GonReina/BudgetODMR/theory/coils/out/coil_designs.txt

== zf_scan_Z: 6 mT at the centre ==
  bore r_in 30 mm (diameter 60 mm), outer r 39.9 mm, winding 9.9 x 9.9 mm
  wire 1.0 mm Cu (1.10 mm enamelled), 9 layers x 9 turns = 81 turns per coil
  spacing 35.1 mm centre-centre (d2B/dz2 = 0);  2.076 mT/A
  current 2.89 A (3.7 A/mm2), 2.6 V, 7.5 W for the pair, R 0.78 ohm cold / 0.89 hot
  wire 36 m for the pair (250 g Cu)
  winding temperature (still air, h=12): 58 C
  inductance 1.47 mH, L/R 1.65 ms, f_3dB 96.6 Hz
  modulation at 1000 Hz: 4.5 V per mT amplitude; 12 V drive -> 2.678 mT
  homogeneity: 1.3e-06 (0.01 uT) over a 2.0 mm cube; 1e-3 region 12.2 mm (axis) x 15.3 mm (dia); 1e-2 region 22.1 x 26.5 mm

== zf_transverse_X: 2 mT at the centre ==
  bore r_in 50 mm (diameter 100 mm), outer r 57.1 mm, winding 7.1 x 7.1 mm
  wire 0.8 mm Cu (0.88 mm enamelled), 8 layers x 8 turns = 64 turns per coil
  spacing 53.6 mm centre-centre (d2B/dz2 = 0);  1.074 mT/A
  current 1.86 A (3.7 A/mm2), 3.0 V, 5.6 W for the pair, R 1.47 ohm cold / 1.63 hot
  wire 43 m for the pair (194 g Cu)
  winding temperature (still air, h=12): 47 C
  inductance 1.82 mH, L/R 1.12 ms, f_3dB 142.0 Hz
  homogeneity: 2.4e-07 (0.00 uT) over a 2.0 mm cube; 1e-3 region 18.6 mm (axis) x 23.5 mm (dia); 1e-2 region 33.7 x 40.6 mm

== zf_transverse_Y: 2 mT at the centre ==
  bore r_in 70 mm (diameter 140 mm), outer r 78.8 mm, winding 8.8 x 8.8 mm
  wire 0.8 mm Cu (0.88 mm enamelled), 10 layers x 10 turns = 100 turns per coil
  spacing 74.5 mm centre-centre (d2B/dz2 = 0);  1.208 mT/A
  current 1.66 A (3.3 A/mm2), 5.9 V, 9.7 W for the pair, R 3.20 ohm cold / 3.53 hot
  wire 94 m for the pair (421 g Cu)
  winding temperature (still air, h=12): 46 C
  inductance 6.39 mH, L/R 1.81 ms, f_3dB 88.0 Hz
  homogeneity: 6.4e-08 (0.00 uT) over a 2.0 mm cube; 1e-3 region 25.9 mm (axis) x 32.5 mm (dia); 1e-2 region 46.8 x 56.5 mm

== zf_modulation: 0.5 mT at the centre ==
  bore r_in 20 mm (diameter 40 mm), outer r 22.2 mm, winding 2.2 x 2.2 mm
  wire 0.5 mm Cu (0.56 mm enamelled), 4 layers x 4 turns = 16 turns per coil
  spacing 21.1 mm centre-centre (d2B/dz2 = 0);  0.681 mT/A
  current 0.73 A (3.7 A/mm2), 0.3 V, 0.2 W for the pair, R 0.37 ohm cold / 0.39 hot
  wire 4 m for the pair (7 g Cu)
  winding temperature (still air, h=12): 29 C
  inductance 0.05 mH, L/R 0.12 ms, f_3dB 1275.4 Hz
  modulation at 1000 Hz: 0.7 V per mT amplitude; 12 V drive -> 16.677 mT
  homogeneity: 9.8e-06 (0.00 uT) over a 2.0 mm cube; 1e-3 region 7.3 mm (axis) x 9.2 mm (dia); 1e-2 region 13.3 x 16.1 mm

== bias_200mT: 200 mT at the centre ==
  bore r_in 15 mm (diameter 30 mm), outer r 115.0 mm, winding 100.0 x 100.0 mm
  wire 1.5 mm Cu (1.64 mm enamelled), 61 layers x 61 turns = 3721 turns per coil
  spacing 102.0 mm centre-centre (windings touching: thicker than Helmholtz allows);  38.143 mT/A
  current 5.24 A (3.0 A/mm2), 155.2 V, 813.6 W for the pair, R 29.59 ohm cold / 29.59 hot  (cold: kept at 20 C)
  wire 3040 m for the pair (48139 g Cu)
  winding temperature (still air, h=12): RUNAWAY: needs forced/water cooling
  inductance 2127.82 mH, L/R 71.91 ms, f_3dB 2.2 Hz
  homogeneity: 1.6e-05 (3.22 uT) over a 2.0 mm cube; 1e-3 region 1.8 mm (axis) x 18.1 mm (dia); 1e-2 region 1.8 x 27.0 mm
