GonReina/BudgetODMR/theory/proposal/selfosc_data/selfosc_fm_gainscan.csv

# self-oscillation gain scan | 2026-07-10T14:34:53 | f_star_MHz=2867.90000 | R0_V=1.01510696e-04 | D_V_per_MHz=1.03149662e-04 | gamma_MHz_per_mT=28.024
gain | cycle | t_s | f_MHz | R_V
0.6 | 0 | 0.4063 | 2867.691707 | 1.37319601e-04
0.6 | 1 | 0.8446 | 2868.028861 | 4.35484304e-05
0.6 | 2 | 1.2444 | 2867.695050 | 1.58898332e-04
0.6 | 3 | 1.6530 | 2867.846327 | 7.55037097e-05
0.6 | 4 | 2.0766 | 2868.037622 | 6.86239940e-05
0.6 | 5 | 2.4769 | 2867.685594 | 1.62029969e-04
0.6 | 6 | 2.8607 | 2868.044443 | 3.98187181e-05
0.6 | 7 | 3.2556 | 2867.718521 | 1.57542056e-04
0.6 | 8 | 3.6530 | 2867.807668 | 8.61848592e-05
0.6 | 9 | 4.1078 | 2867.882835 | 8.85883140e-05
0.6 | 10 | 4.5073 | 2867.768125 | 1.21231045e-04
0.6 | 11 | 4.9361 | 2867.765034 | 1.02042143e-04
0.6 | 12 | 5.3254 | 2867.793601 | 9.65995903e-05
0.6 | 13 | 5.7692 | 2867.848765 | 9.20271381e-05
0.6 | 14 | 6.1691 | 2867.769192 | 1.15190554e-04
0.6 | 15 | 6.5727 | 2867.785905 | 9.86375263e-05
0.6 | 16 | 7.0047 | 2867.816051 | 9.63279689e-05
0.6 | 17 | 7.3932 | 2867.758578 | 1.11391378e-04
0.6 | 18 | 7.7631 | 2867.789473 | 9.61992811e-05
0.6 | 19 | 8.1439 | 2867.814168 | 9.72651455e-05
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
