GonReina/BudgetODMR/theory/proposal/selfosc_data/selfosc_fm_spectrum.csv

# FM spectrum for self-oscillation run | 2026-07-10T14:34:53
freq_MHz | lockin_R
2850.00000 | 0.00000346
2850.10000 | 0.00000360
2850.20000 | 0.00000509
2850.30000 | 0.00000436
2850.40000 | 0.00000346
2850.50000 | 0.00001463
2850.60000 | 0.00000360
2850.70000 | 0.00000555
2850.80000 | 0.00000328
2850.90000 | 0.00000278
2851.00000 | 0.00000280
2851.10000 | 0.00000508
2851.20000 | 0.00000144
2851.30000 | 0.00000439
2851.40000 | 0.00000431
2851.50000 | 0.00000541
2851.60000 | 0.00000392
2851.70000 | 0.00000346
2851.80000 | 0.00000283
2851.90000 | 0.00000436
2852.00000 | 0.00000338
2852.10000 | 0.00000444
2852.20000 | 0.00000592
2852.30000 | 0.00000591
2852.40000 | 0.00000561
2852.50000 | 0.00000537
2852.60000 | 0.00000398
2852.70000 | 0.00000414
2852.80000 | 0.00000983
2852.90000 | 0.00000509
2853.00000 | 0.00000732
2853.10000 | 0.00000578
2853.20000 | 0.00000780
2853.30000 | 0.00000422
2853.40000 | 0.00000846
2853.50000 | 0.00000927
2853.60000 | 0.00000933
2853.70000 | 0.00000434
2853.80000 | 0.00000903
2853.90000 | 0.00000498
2854.00000 | 0.00000537
2854.10000 | 0.00000471
2854.20000 | 0.00000595
2854.30000 | 0.00000628
2854.40000 | 0.00000689
2854.50000 | 0.00000627
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
