GonReina/BudgetODMR/theory/proposal/selfosc_data/selfosc_fm_stats.csv

# self-oscillation statistics | 2026-07-10T14:34:53 | gain=2.3 | f_star_MHz=2867.90000 | R0_V=1.01510696e-04 | D_V_per_MHz=1.03149662e-04
cycle | t_s | f_MHz | R_V
0 | 0.4305 | 2868.433662 | 7.75771821e-05
1 | 0.7725 | 2865.228724 | 2.45244733e-04
2 | 1.1687 | 2861.542838 | 2.66814139e-04
3 | 1.6156 | 2860.656032 | 1.41281872e-04
4 | 2.0041 | 2861.942542 | 4.38136999e-05
5 | 2.3978 | 2862.690450 | 6.79687813e-05
6 | 2.8294 | 2863.563481 | 6.23572760e-05
7 | 3.2189 | 2861.874308 | 1.77266204e-04
8 | 3.6149 | 2862.525684 | 7.22979713e-05
9 | 4.0369 | 2862.985278 | 8.08989680e-05
10 | 4.4504 | 2862.340044 | 1.30447947e-04
11 | 4.8347 | 2862.706690 | 8.50674689e-05
12 | 5.2635 | 2863.803029 | 5.23424467e-05
13 | 5.6672 | 2861.776788 | 1.92382904e-04
14 | 6.0629 | 2862.575888 | 6.56729076e-05
15 | 6.4957 | 2863.454125 | 6.21237973e-05
16 | 6.8851 | 2861.869283 | 1.72587207e-04
17 | 7.2818 | 2862.632355 | 6.72886925e-05
18 | 7.7025 | 2863.878647 | 4.56173721e-05
19 | 8.1175 | 2861.684772 | 1.99900884e-04
20 | 8.5503 | 2861.892376 | 9.22001641e-05
21 | 8.9338 | 2862.631852 | 6.83469000e-05
22 | 9.3281 | 2862.608349 | 1.02564735e-04
23 | 9.7619 | 2862.621431 | 1.00924012e-04
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
