GonReina/BudgetODMR/analysis/vsystem_sim_out/fig1_spectra.png

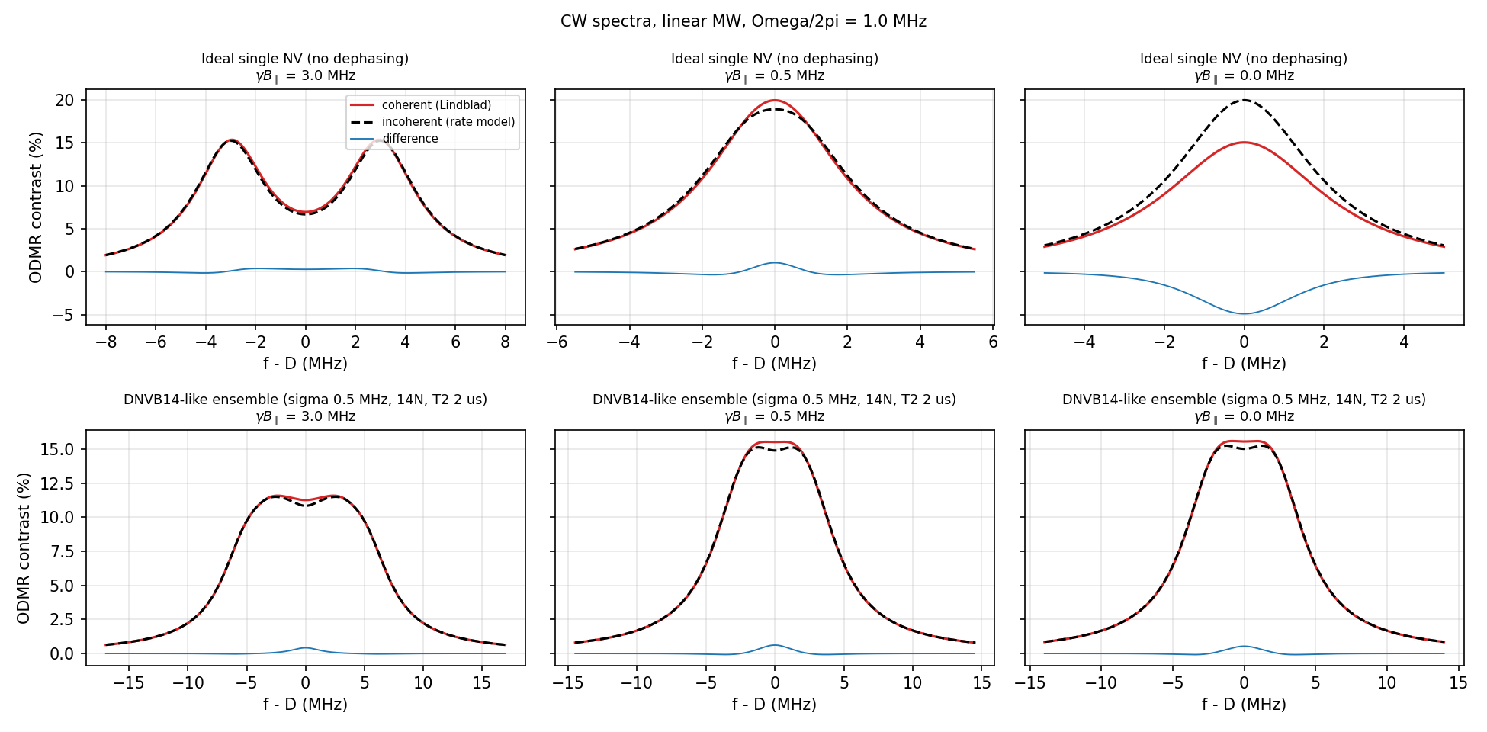
analysis/vsystem_sim_out/fig1_spectra.png
