GonReina/BudgetODMR/analysis/vsystem_sim_out/fig3_washout.png

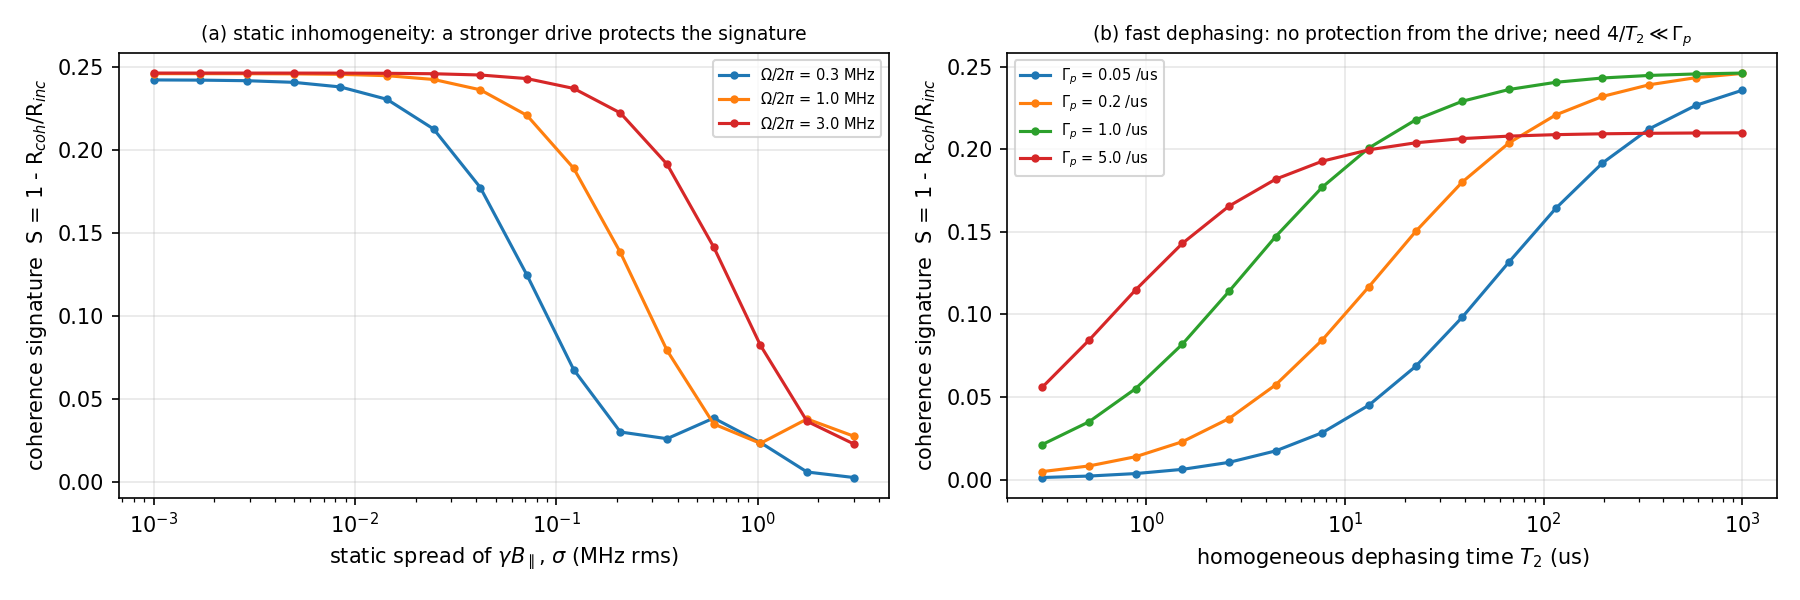
analysis/vsystem_sim_out/fig3_washout.png
