GonReina/BudgetODMR/analysis/vsystem_sim_out/fig4_lineshape_ambiguity.png

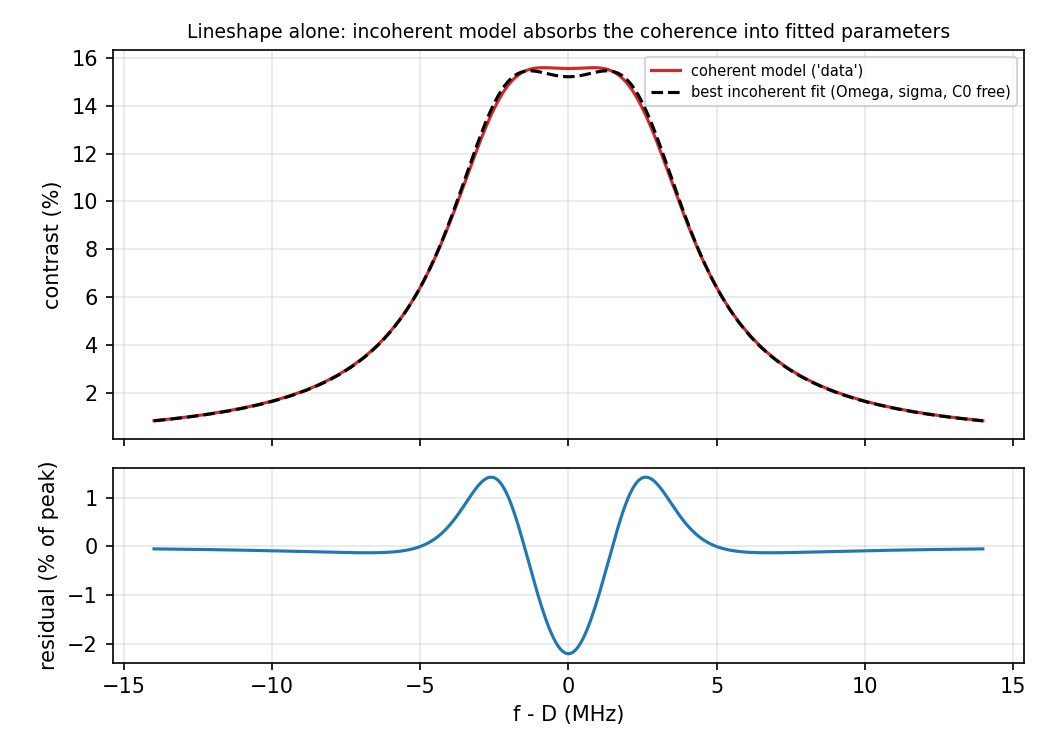
analysis/vsystem_sim_out/fig4_lineshape_ambiguity.png
