GonReina/BudgetODMR/analysis/vsystem_sim_out/fig5_time_domain.png

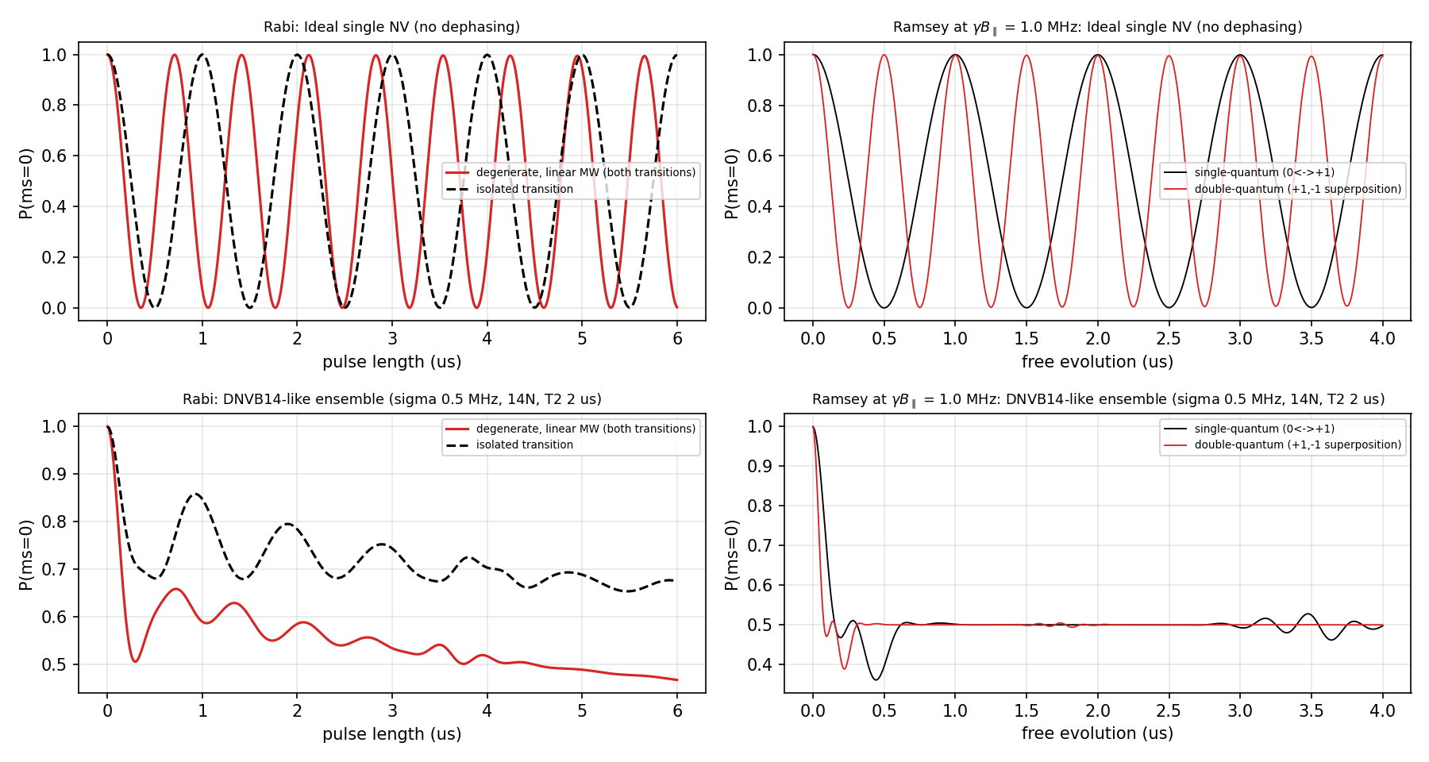
analysis/vsystem_sim_out/fig5_time_domain.png
