GonReina/BudgetODMR/analysis/vsystem_sim_out/fig6_pl_vs_rabi.png

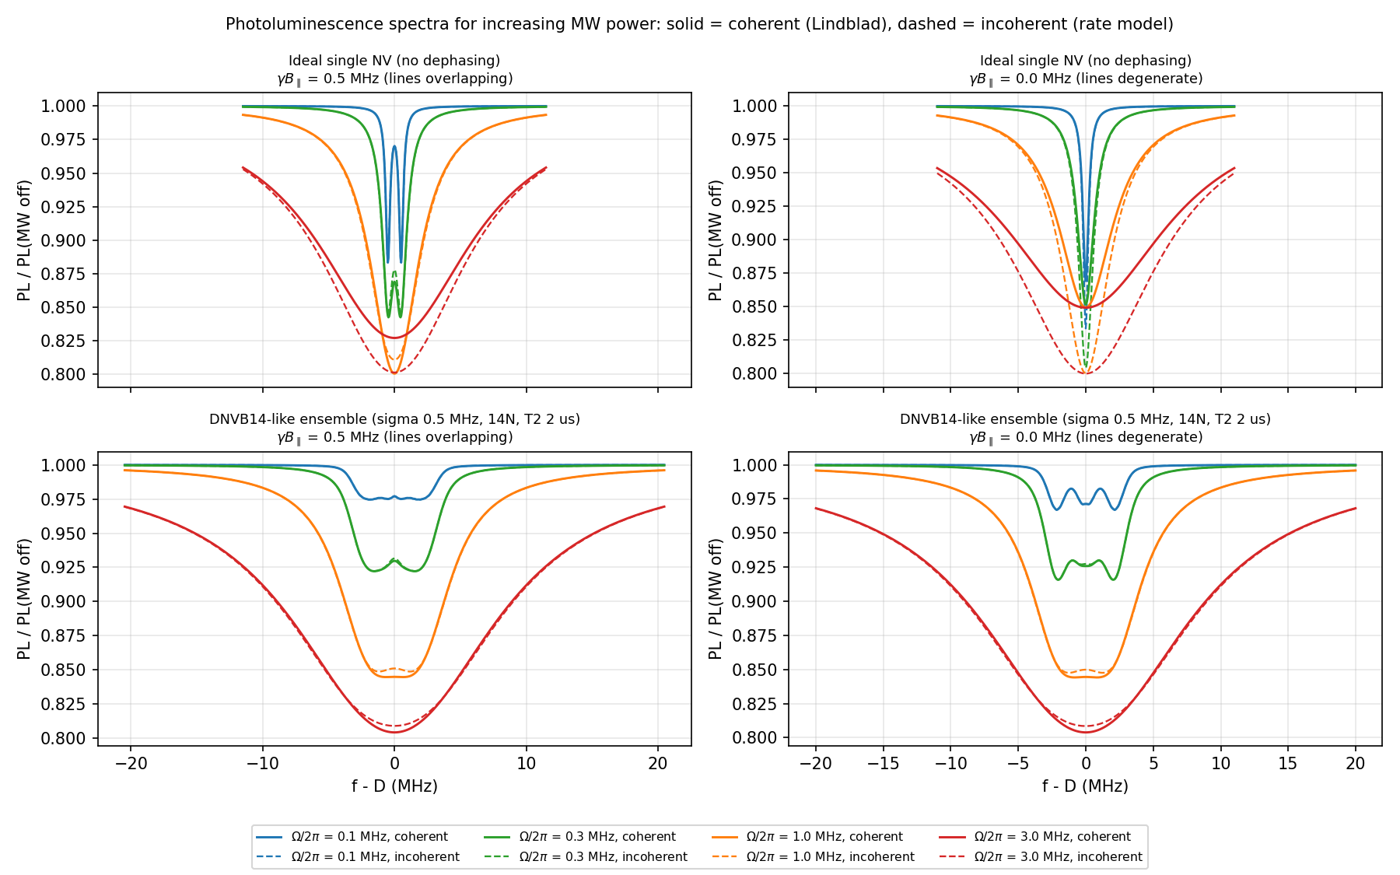
analysis/vsystem_sim_out/fig6_pl_vs_rabi.png
