GonReina/BudgetODMR/analysis/vsystem_sim_out/fig7_strain.png

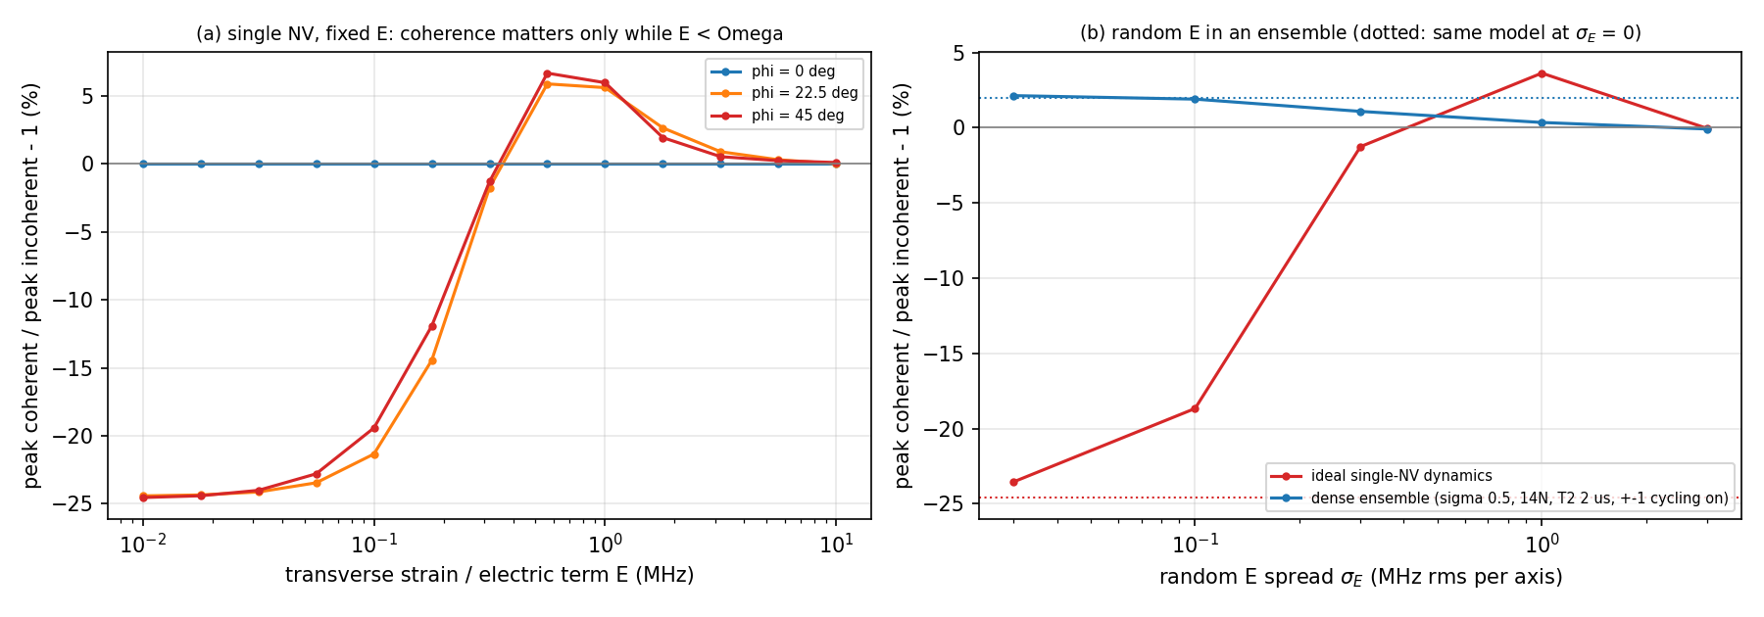
analysis/vsystem_sim_out/fig7_strain.png
