GonReina/BudgetODMR/proposal/fig4_threshold_detection.png

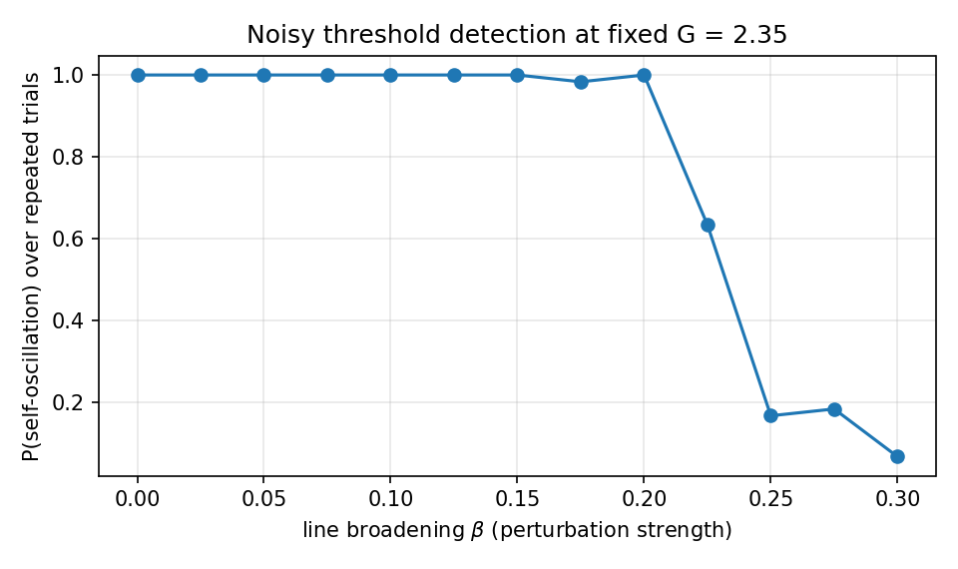
proposal/fig4_threshold_detection.png
