GonReina/BudgetODMR/proposal/figures/fig3_onset_sensor.png

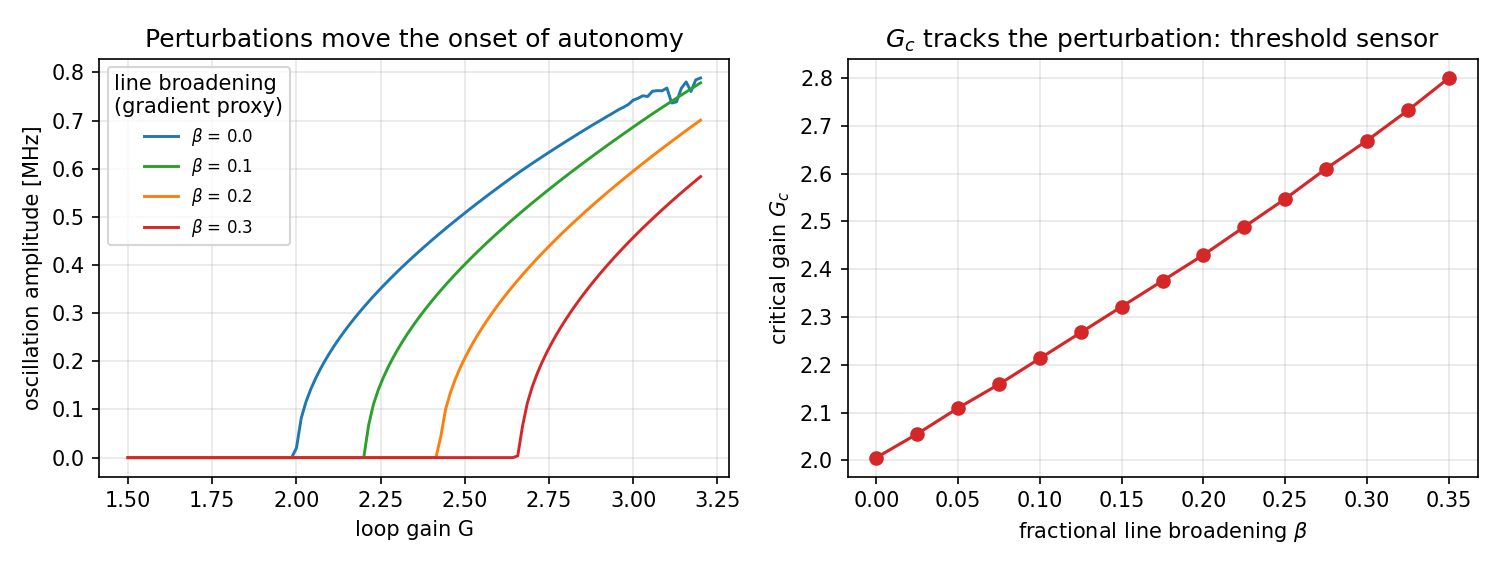
proposal/figures/fig3_onset_sensor.png
