GonReina/BudgetODMR/theory/coils/cad/preview/v1_single_axis.png

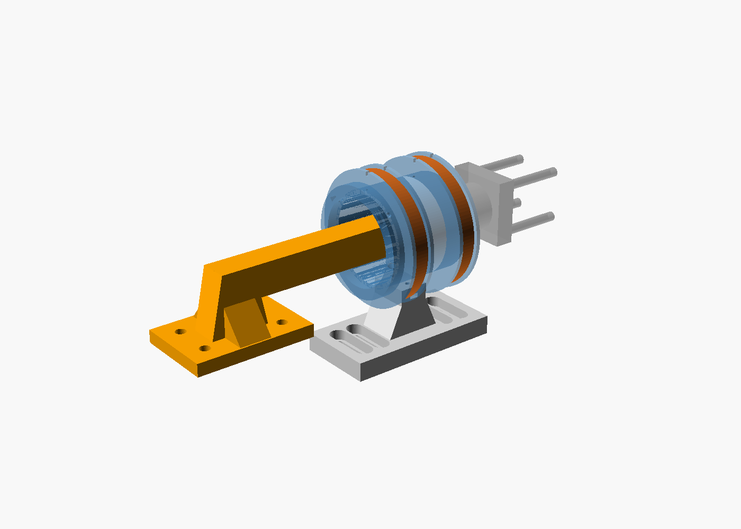
theory/coils/cad/preview/v1_single_axis.png
