GonReina/BudgetODMR/theory/coils/cad/preview/v3_three_axis.png

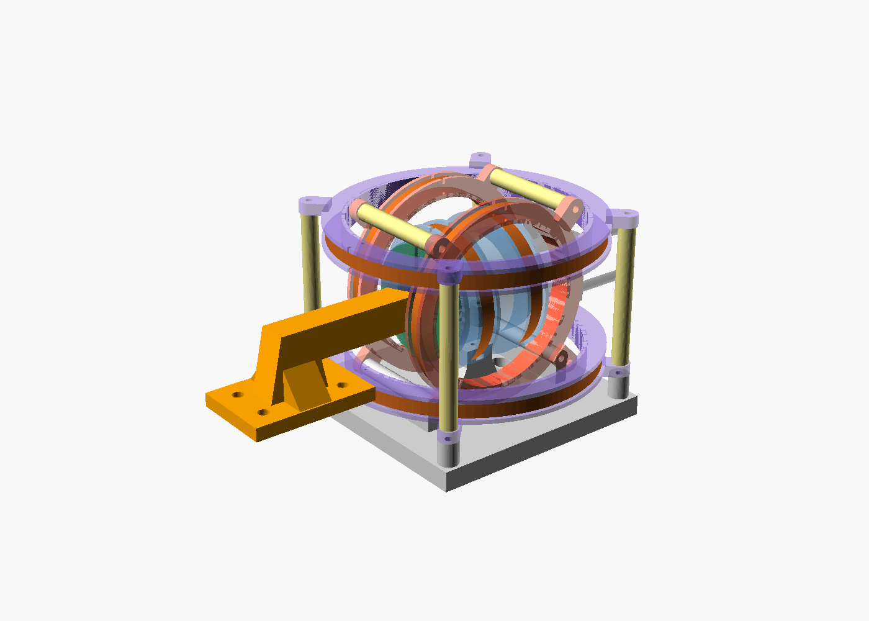
theory/coils/cad/preview/v3_three_axis.png
