GonReina/BudgetODMR/theory/coils/out/coil_bias_200mT.png

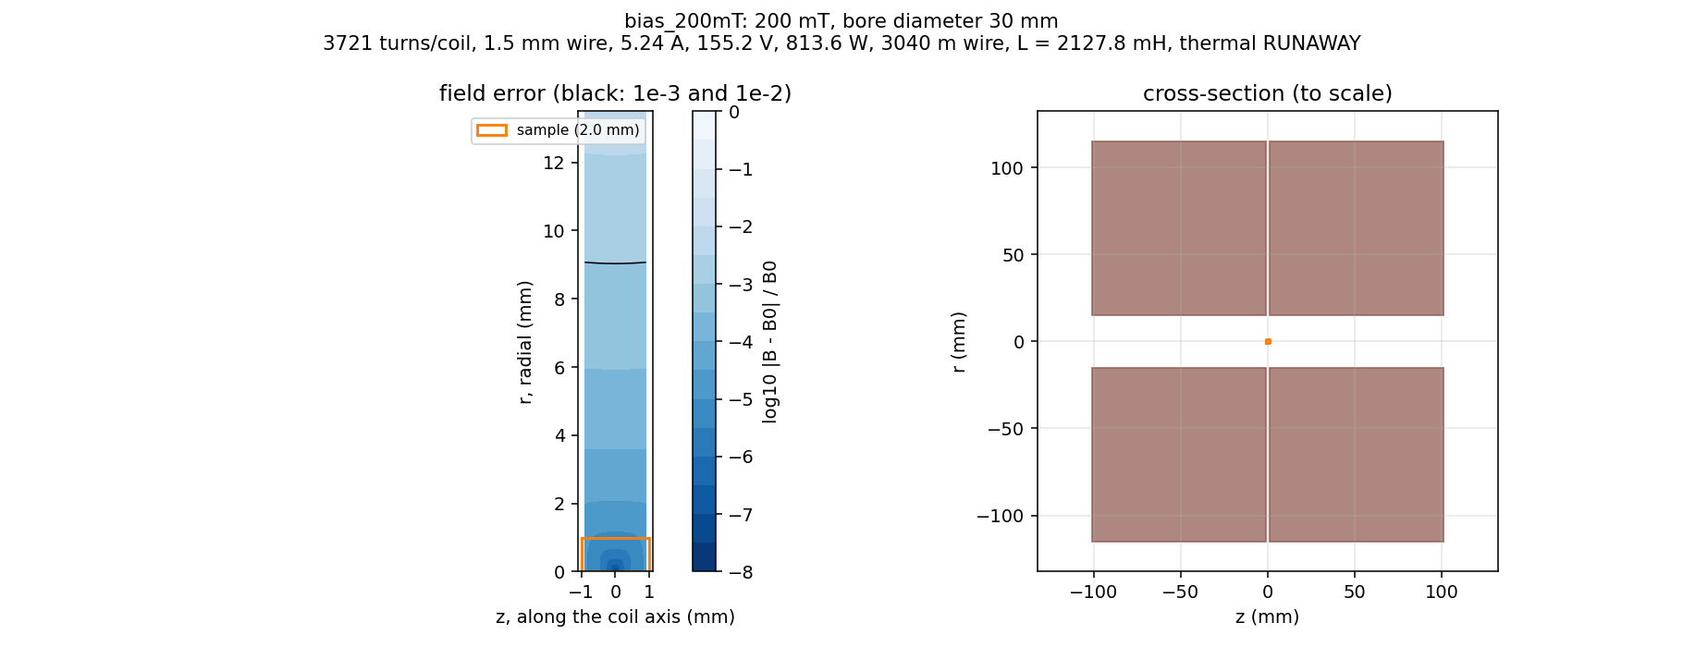
theory/coils/out/coil_bias_200mT.png
