GonReina/BudgetODMR/theory/coils/out/coil_sweep.png

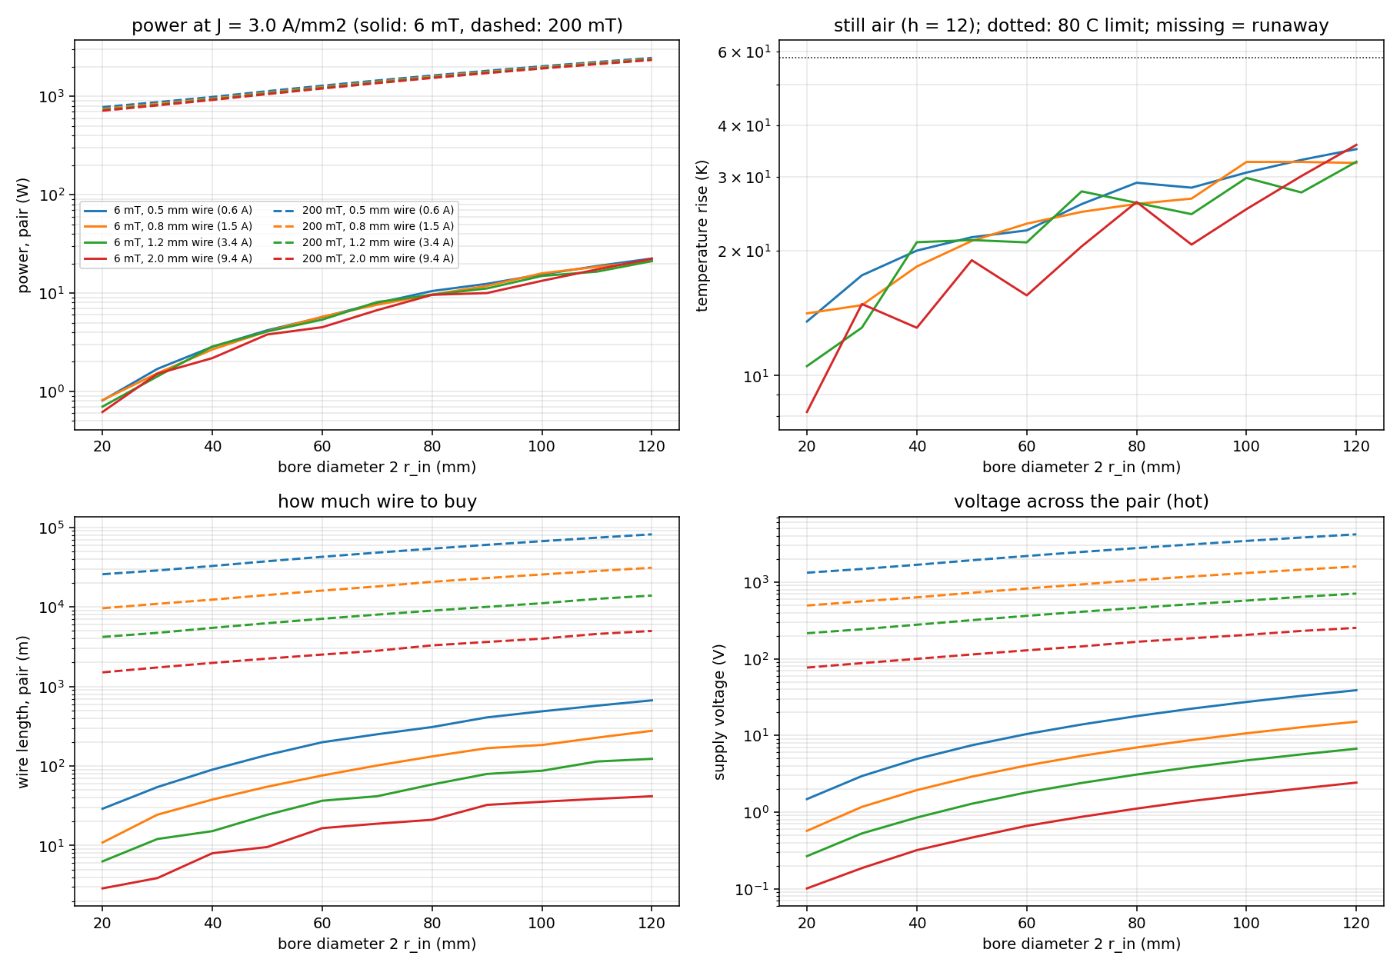
theory/coils/out/coil_sweep.png
