GonReina/BudgetODMR/theory/coils/out/coil_zf_modulation.png

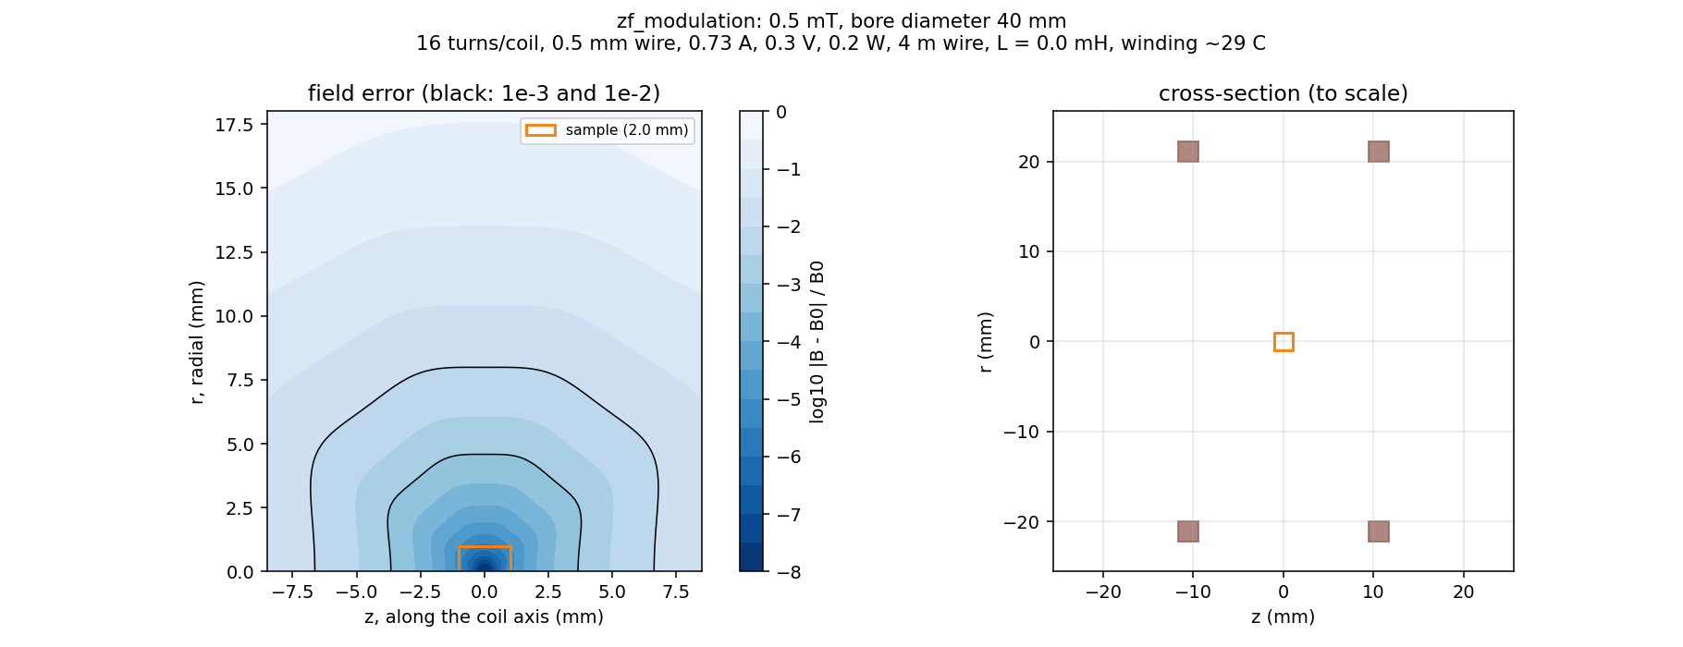
theory/coils/out/coil_zf_modulation.png
