GonReina/BudgetODMR/theory/coils/out/coil_zf_scan_Z.png

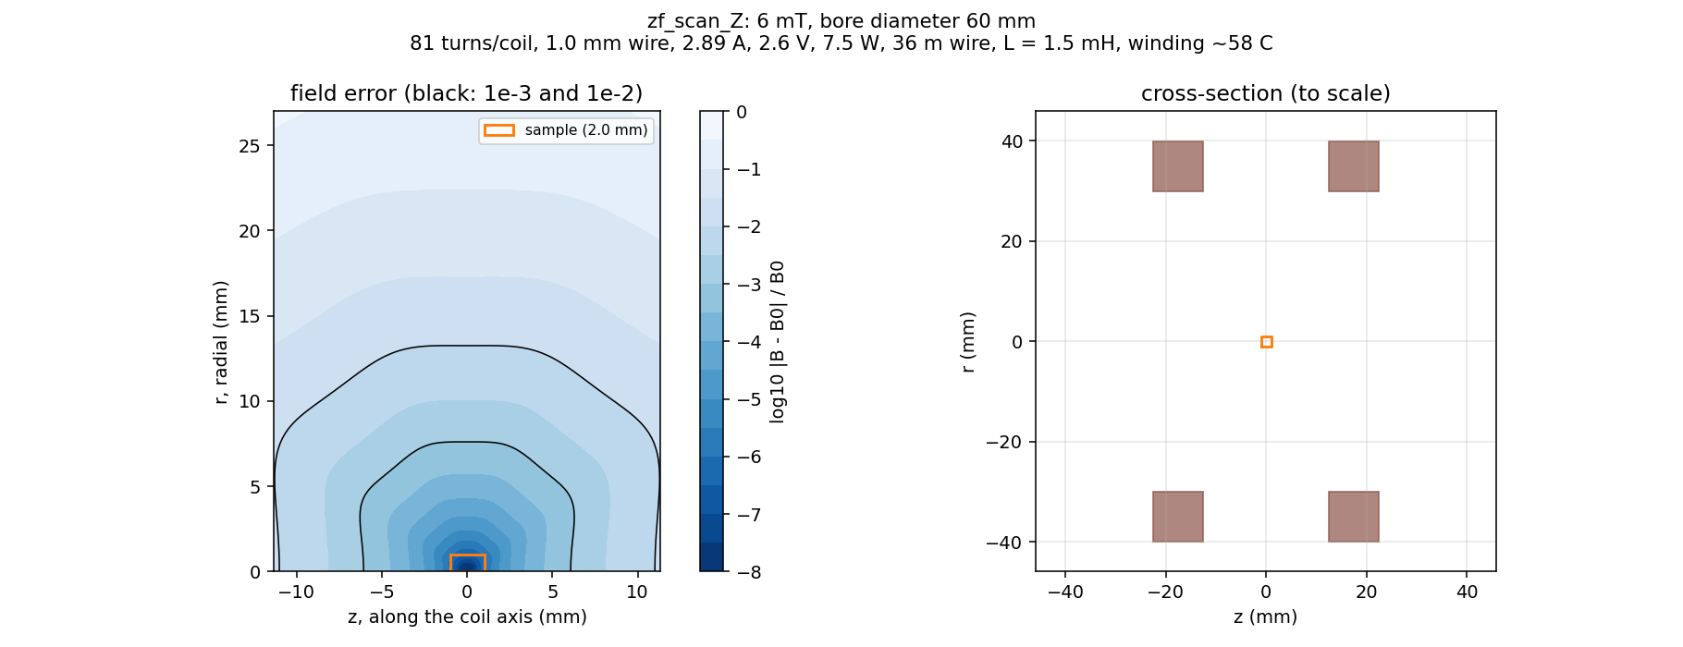
theory/coils/out/coil_zf_scan_Z.png
