GonReina/BudgetODMR/theory/coils/out/coil_zf_transverse_X.png

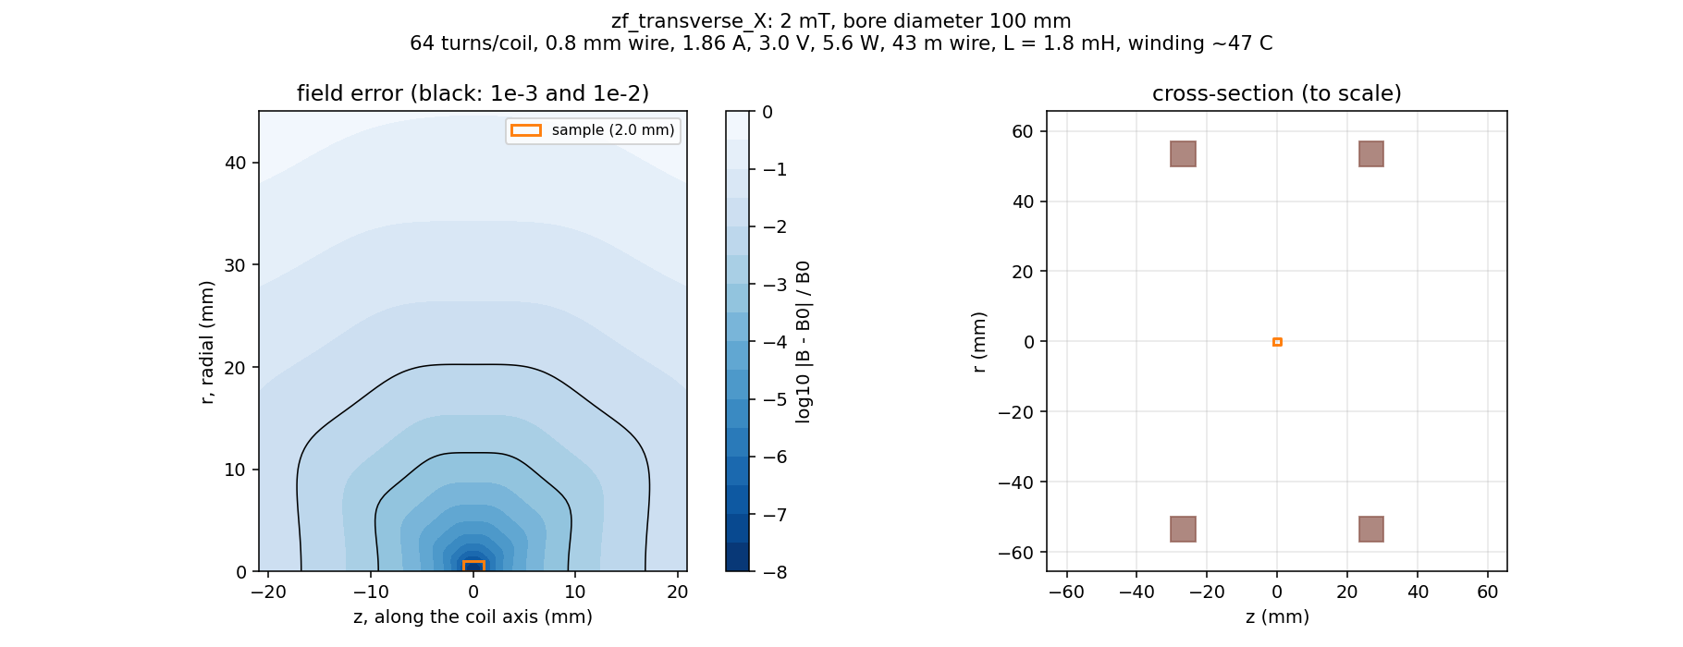
theory/coils/out/coil_zf_transverse_X.png
