GonReina/BudgetODMR/theory/proposal/figures/fig5_statistics_readout.png

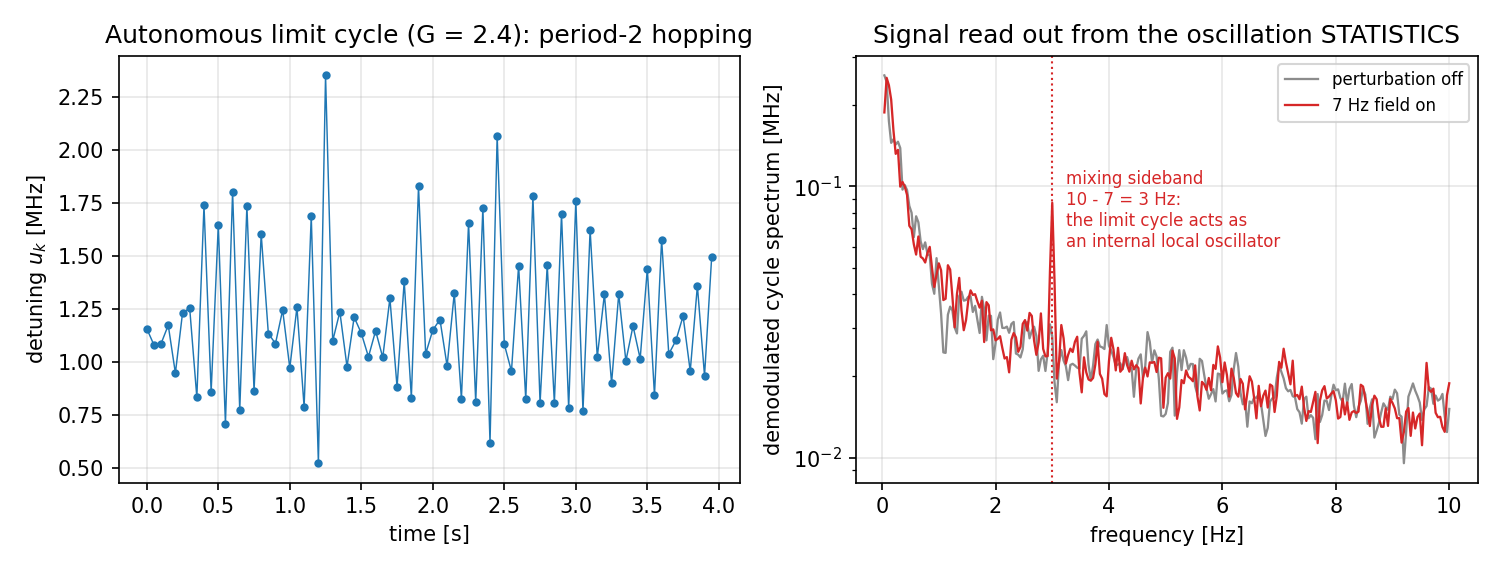
theory/proposal/figures/fig5_statistics_readout.png
