GonReina/BudgetODMR/procurement/NV_upgrade_shopping_list.xlsx

Sheet: Shopping list
BudgetODMR - NV magnetometer upgrade, procurement plan
All prices EUR, EXCLUDING VAT (21 % ES), as displayed by the vendor on 10 Sep 2026. Blue = price taken from our own earlier quote or an estimate; black = verified on the linked vendor page.
Tier | Group | Item | Part no. | Supplier | Qty | Unit price (EUR, ex-VAT) | Line total (EUR) | URL | Purpose / justification
1. Fluorescence collection & detection
A - core (3 k tranche) | 1. Fluorescence collection & detection | Si switchable-gain photodetector, 75.4 mm² active area | PDA100A2 | Thorlabs | 1 | 399.87 EUR | 399.87 EUR | https://www.thorlabs.com/thorproduct.cfm?partnumber=PDA100A2 | Dedicated high-collection ensemble channel: 94x larger area than the PDA10A2 and 8 selectable gains, so bandwidth we do not need is traded for transimpedance we do. Directly attacks the 0.1 mV lock-in signal.
A - core (3 k tranche) | 1. Fluorescence collection & detection | Aspheric condenser, Ø25 mm, f = 16 mm, NA = 0.79, AR 650-1050 nm | ACL25416U-B | Thorlabs | 2 | 31.21 EUR | 62.42 EUR | https://www.thorlabs.com/thorproduct.cfm?partnumber=ACL25416U-B | High-NA collection of NV emission close to the diamond, feeding the large-area detector. Far more efficient than re-using the 40x objective for ensemble work.
A - core (3 k tranche) | 1. Fluorescence collection & detection | SM1 lens tube, 1 in | SM1L10 | Thorlabs | 2 | 14.99 EUR | 29.98 EUR | https://www.thorlabs.com/thorproduct.cfm?partnumber=SM1L10 | Builds the condenser + filter + detector head as one light-tight tube.
A - core (3 k tranche) | 1. Fluorescence collection & detection | Lens mount for Ø1 in optics, M4 tap | LMR1/M | Thorlabs | 2 | 16.02 EUR | 32.04 EUR | https://www.thorlabs.com/thorproduct.cfm?partnumber=LMR1/M | Mounting for the condenser lenses.
A - core (3 k tranche) | 1. Fluorescence collection & detection | Ø25 mm longpass filter, 650 nm cut-on | FELH0650 | Thorlabs | 1 | 153.86 EUR | 153.86 EUR | https://www.thorlabs.com/thorproduct.cfm?partnumber=FELH0650 | Rejects residual 532 nm and most room light while passing the NV phonon sideband (650-800 nm). Raises contrast by cutting background, not signal.
2. Stray-light control
A - core (3 k tranche) | 2. Stray-light control | Black hardboard, 610 x 610 mm, 3 sheets per pack | TB4 | Thorlabs | 2 | 73.95 EUR | 147.90 EUR | https://www.thorlabs.com/thorproduct.cfm?partnumber=TB4 | Rigid light-tight enclosure around the confocal head - the blocker for any low-light / single-NV work.
A - core (3 k tranche) | 2. Stray-light control | Blackout fabric, 1.5 m x 2.7 m | BK5 | Thorlabs | 1 | 61.64 EUR | 61.64 EUR | https://www.thorlabs.com/thorproduct.cfm?partnumber=BK5 | Drapes the enclosure and the table edges.
A - core (3 k tranche) | 2. Stray-light control | Matte black aluminium foil, 305 mm x 15.2 m | BKF12 | Thorlabs | 2 | 35.37 EUR | 70.74 EUR | https://www.thorlabs.com/thorproduct.cfm?partnumber=BKF12 | Mouldable foil to seal exactly the failure mode we have: cable holes and small apertures.
A - core (3 k tranche) | 2. Stray-light control | Beam trap, 400 nm - 2.5 µm, 30 W | BT610/M | Thorlabs | 1 | 342.00 EUR | 342.00 EUR | https://www.thorlabs.com/thorproduct.cfm?partnumber=BT610/M | Terminates the transmitted/reflected green safely instead of scattering it around the enclosure. Laser-safety item as well.
3. Fibre coupling
A - core (3 k tranche) | 3. Fibre coupling | Achromatic FiberPort, FC/PC & FC/APC, f = 7.5 mm, 400-700 nm | PAF2-A7A | Thorlabs | 1 | 681.22 EUR | 681.22 EUR | https://www.thorlabs.com/thorproduct.cfm?partnumber=PAF2-A7A | Integrated 5-axis fibre launch (x, y, focus + 2 tilts). Our current kinematic-mount approach cannot translate the fibre tip, which is why coupling has never succeeded. NOTE: check the collimated beam diameter first and pick the matching focal length (A4A 0.65 mm / A7A 1.23 mm / A10A / A15A) - all cost the same.
4. Microwave power characterisation
A - core (3 k tranche) | 4. Microwave power characterisation | Fixed attenuator 30 dB, 20 W, DC-18 GHz, SMA | BW-S30W20+ | DigiKey ES | 1 | 203.85 EUR | 203.85 EUR | https://www.digikey.es/es/products/detail/mini-circuits/BW-S30W20/16682977 | Lets the 16 W amplifier output be measured safely. Needed to find where the ZHL-16W-43-S+ compresses: with +16 dBm drive it is almost certainly saturated, so 'MW power' set on the SMCV may not be the power at the antenna.
A - core (3 k tranche) | 4. Microwave power characterisation | RF power detector, 10 MHz - 8 GHz, DC log output | ZX47-40-S+ | DigiKey ES | 1 | 149.31 EUR | 149.31 EUR | https://www.digikey.es/es/products/detail/mini-circuits/ZX47-40-S/21727781 | Calibrated MW power axis for the linewidth-vs-power (Rabi) experiment; DC output readable by the multimeter or the Red Pitaya.
A - core (3 k tranche) | 4. Microwave power characterisation | Absorptive SPDT RF switch, DC-5 GHz, TTL control | ZASWA-2-50DRA+ | DigiKey ES | 1 | 189.93 EUR | 189.93 EUR | https://www.digikey.es/es/products/result?keywords=ZASWA-2-50DRA%2B | TTL-gated MW from the Red Pitaya: deep 100% amplitude modulation for lock-in, MW on/off normalisation, and a first step towards pulsed sequences.
A - core (3 k tranche) | 4. Microwave power characterisation | Ultra-flexible SMA cable | (as quoted) | Mouser | 4 | 20.35 EUR | 81.40 EUR | https://www.mouser.es/c/?q=ultra%20flexible%20sma%20cable | Replaces stiff cables that torque the antenna and change coupling between runs. Price from our own earlier quote.
A - core (3 k tranche) | 4. Microwave power characterisation | SMA edge-launch connectors (antenna build) | (as quoted) | Mouser | 8 | 7.17 EUR | 57.36 EUR | https://www.mouser.es/c/connectors/rf-coaxial-connectors/ | For the resonant loop / Omega antenna PCB - stronger B1 is the cheapest route to better ODMR contrast. Price from our own earlier quote.
5. Temperature & drift
A - core (3 k tranche) | 5. Temperature & drift | USB temperature + humidity logger with external probe | TSP01 | Thorlabs | 1 | 158.29 EUR | 158.29 EUR | https://www.thorlabs.com/thorproduct.cfm?partnumber=TSP01 | Logs lab temperature alongside every ODMR run so drift in D (-74 kHz/K) can be separated from magnetic drift. Enables the thermometry experiment.
A - core (3 k tranche) | 5. Temperature & drift | Flexible polyimide heater with 10 kΩ thermistor | HT10K | Thorlabs | 2 | 59.79 EUR | 119.58 EUR | https://www.thorlabs.com/thorproduct.cfm?partnumber=HT10K | Deliberately warm the diamond mount to measure dD/dT and calibrate the setup as a thermometer; also quantifies laser-induced heating.
A - core (3 k tranche) | 5. Temperature & drift | 10 kΩ thermistor (spares / extra sensing points) | TH10K | Thorlabs | 4 | 4.84 EUR | 19.36 EUR | https://www.thorlabs.com/thorproduct.cfm?partnumber=TH10K | Additional temperature sensing points (antenna, amplifier, diamond mount).
6. Optics cleaning & consumables
A - core (3 k tranche) | 6. Optics cleaning & consumables | Lens tissues, 5 booklets | MC-5 | Thorlabs | 1 | 11.34 EUR | 11.34 EUR | https://www.thorlabs.com/thorproduct.cfm?partnumber=MC-5 | Standard drag-wipe cleaning of objective, filters and fibre ends.
A - core (3 k tranche) | 6. Optics cleaning & consumables | Optical-grade cotton-tipped applicators, 100 pack | CTA10 | Thorlabs | 1 | 4.97 EUR | 4.97 EUR | https://www.thorlabs.com/thorproduct.cfm?partnumber=CTA10 | Solvent cleaning of connector ferrules and small optics.
A - core (3 k tranche) | 6. Optics cleaning & consumables | Reagent-grade alcohol | (as quoted) | Amazon | 1 | 8.39 EUR | 8.39 EUR | https://www.amazon.es/s?k=isopropanol+99.9+reagent+grade | Cleaning solvent. Price from our own earlier quote.
A - core (3 k tranche) | 6. Optics cleaning & consumables | Deionised water | (as quoted) | Amazon | 1 | 10.30 EUR | 10.30 EUR | https://www.amazon.es/s?k=agua+desionizada | Cleaning solvent. Price from our own earlier quote.
 |  | TIER A SUBTOTAL - core upgrade (3,000 EUR tranche) |  |  |  |  | 2995.75 EUR
7. Balanced detection (laser-noise cancellation)
B - extension (2 k tranche) | 7. Balanced detection (laser-noise cancellation) | Si switchable-gain photodetector (reference channel) | PDA100A2 | Thorlabs | 1 | 399.87 EUR | 399.87 EUR | https://www.thorlabs.com/thorproduct.cfm?partnumber=PDA100A2 | Second identical detector on a pick-off of the excitation beam. Fed differentially into the MFLI it cancels common-mode laser intensity noise - the term the noise-budget script is most likely to find dominant.
B - extension (2 k tranche) | 7. Balanced detection (laser-noise cancellation) | Ø1 in UVFS wedged beam sampler, AR 350-700 nm | BSF10-A | Thorlabs | 1 | 72.51 EUR | 72.51 EUR | https://www.thorlabs.com/thorproduct.cfm?partnumber=BSF10-A | Picks off a few % of the green for the reference detector without disturbing the main beam.
8. Laser power control
B - extension (2 k tranche) | 8. Laser power control | Ø1 in linear polariser, 400-700 nm | LPVISE100-A | Thorlabs | 1 | 103.08 EUR | 103.08 EUR | https://www.thorlabs.com/thorproduct.cfm?partnumber=LPVISE100-A | With the rotation mount, gives continuous laser power control (Malus law) on the linearly polarised DPSS output - needed to take clean laser-power dependences without changing diode current (which changes noise and mode).
B - extension (2 k tranche) | 8. Laser power control | Rotation mount for Ø1 in optics, M4 tap | RSP1/M | Thorlabs | 1 | 95.73 EUR | 95.73 EUR | https://www.thorlabs.com/thorproduct.cfm?partnumber=RSP1/M | Rotates the polariser; also serves the half-wave plate later.
B - extension (2 k tranche) | 8. Laser power control | Absorptive ND filter OD 1.0, SM1-mounted | NE10A | Thorlabs | 1 | 58.34 EUR | 58.34 EUR | https://www.thorlabs.com/thorproduct.cfm?partnumber=NE10A | Coarse, repeatable power steps for power-dependence series.
B - extension (2 k tranche) | 8. Laser power control | Absorptive ND filter OD 2.0, SM1-mounted | NE20A | Thorlabs | 1 | 58.34 EUR | 58.34 EUR | https://www.thorlabs.com/thorproduct.cfm?partnumber=NE20A | As above, decade step.
9. Sample & fibre infrastructure
B - extension (2 k tranche) | 9. Sample & fibre infrastructure | PM patch cable, PANDA, 488 nm, FC/APC, 2 m | P3-488PM-FC-2 | Thorlabs | 1 | 282.24 EUR | 282.24 EUR | https://www.thorlabs.com/thorproduct.cfm?partnumber=P3-488PM-FC-2 | Spare/second fibre better matched to 532 nm than the 405 nm PM cable, and insurance against an end face damaged during coupling attempts. Keep connector types consistent (APC-APC) across the launch.
B - extension (2 k tranche) | 9. Sample & fibre infrastructure | 30 mm cage cube precision kinematic rotation platform | B4CRP/M | Thorlabs | 1 | 333.91 EUR | 333.91 EUR | https://www.thorlabs.com/thorproduct.cfm?partnumber=B4CRP/M | Rotates the diamond + antenna assembly reproducibly: NV-orientation studies, vector magnetometry, and repeatable magnet geometry. Already on our wish list.
B - extension (2 k tranche) | 9. Sample & fibre infrastructure | SM1 lens tube, 1 in (light shielding spares) | SM1L10 | Thorlabs | 2 | 14.99 EUR | 29.98 EUR | https://www.thorlabs.com/thorproduct.cfm?partnumber=SM1L10 | Extra shielding tubes for the detection path.
B - extension (2 k tranche) | 9. Sample & fibre infrastructure | Aspheric condenser (spare / second channel) | ACL25416U-B | Thorlabs | 1 | 31.21 EUR | 31.21 EUR | https://www.thorlabs.com/thorproduct.cfm?partnumber=ACL25416U-B | Spare for the balanced/second collection channel.
10. Field calibration
B - extension (2 k tranche) | 10. Field calibration | Calibration coil build: magnet wire, 3D-printed former, precision sense resistor | (build) | RS / Farnell / in-house | 1 | 80.00 EUR | 80.00 EUR | https://es.rs-online.com/web/c/cables-hilos/hilo-electrico/hilo-de-cobre-esmaltado/ | ESTIMATE. A coil of known geometry driven by the KA3010P or the Red Pitaya applies a computable field (N, r, I) so the nT/sqrt(Hz) sensitivity becomes traceable instead of relative, and gives a known AC signal for the WP3 statistics test.
11. Environment & contingency
B - extension (2 k tranche) | 11. Environment & contingency | Air purifier (optics dust control) | (as quoted) | Amazon | 1 | 199.00 EUR | 199.00 EUR | https://www.amazon.es/s?k=purificador+de+aire+HEPA | Reduces dust settling on the diamond, objective and open optics in a shared room. Price from our own earlier quote.
B - extension (2 k tranche) | 11. Environment & contingency | Cotton applicators + lens tissue (restock) | CTA10 / MC-5 | Thorlabs | 1 | 21.28 EUR | 21.28 EUR | https://www.thorlabs.com/thorproduct.cfm?partnumber=CTA10 | Consumable restock (2x CTA10 + 1x MC-5).
B - extension (2 k tranche) | 11. Environment & contingency | Contingency: shipping, M4/M6 adapters, low-profile screws, SMA savers | (various) | various | 1 | 234.00 EUR | 234.00 EUR | https://www.thorlabs.com/navigation.cfm?guide_id=51 | ESTIMATE. Small mechanical hardware identified during assembly plus carriage; keeps the tranche from stalling on 10 EUR parts.
 |  | TIER B SUBTOTAL - extension (2,000 EUR tranche) |  |  |  |  | 1999.49 EUR
 |  | GRAND TOTAL (ex-VAT) |  |  |  |  | 4995.24 EUR
 |  | Memo: same total including 21 % Spanish VAT |  |  |  |  | 6044.24 EUR | Check with the finance office which basis the 3 k + 2 k awards are quoted on.
Budget check
 |  | Tier A vs 3,000 EUR available |  |  |  |  | 4.25 EUR
 |  | Tier B vs 2,000 EUR available |  |  |  |  | 0.51 EUR
 |  | Total headroom vs 5,000 EUR |  |  |  |  | 4.76 EUR

Sheet: Considered - not bought
Items evaluated and deliberately excluded
Item | Indicative price (EUR) | Why it is not in this request
Single-photon counting module (e.g. Excelitas SPCM-AQRH) | ~6,000-8,000 | The only real route to single-NV work: the APD430A is an analogue detector and a single NV delivers femtoamps. Out of scope for this budget; propose as a separate capital request.
Zero-order half-wave plate WPH10M-532 (605.44) + mount | 605.44 | Would add NV-orientation-selective excitation on top of power control. Deferred - the polariser alone already gives continuous power control. First item to add if funds free up.
Thorlabs NEK01 ND filter kit (10 filters) | 617.07 | Two individual ND filters cover the needed range at 1/5 of the cost.
3B Scientific Helmholtz coil pair U8481500 | ~700 | Turnkey but 300 mm coils are oversized for the table and the field is easily computed from a wound coil at ~1/8 the price.
Second NV diamond with lower NV density | ~1,000-3,700 | Would give narrower lines and a resolvable 14N triplet for the Rabi work. Too expensive here; the existing ELSC20 should be tried first.
Zurich Instruments MFLI options (MF-MD multi-demodulator, MF-PID) | quote required | The only software licences worth considering: MF-MD would demodulate 1f and 2f simultaneously (derivative + absorption in one pass), MF-PID would move the WP3 feedback loop into hardware. Both need a quote from ZI - request before committing budget.
Analysis software licence (Origin, MATLAB, LabVIEW) | n/a | Not recommended: the acquisition and analysis stack is already Python/numpy/matplotlib and is written and tested.
