GonReina/BudgetODMR/theory/coils/cad/stl/v1_single_axis/base.stl

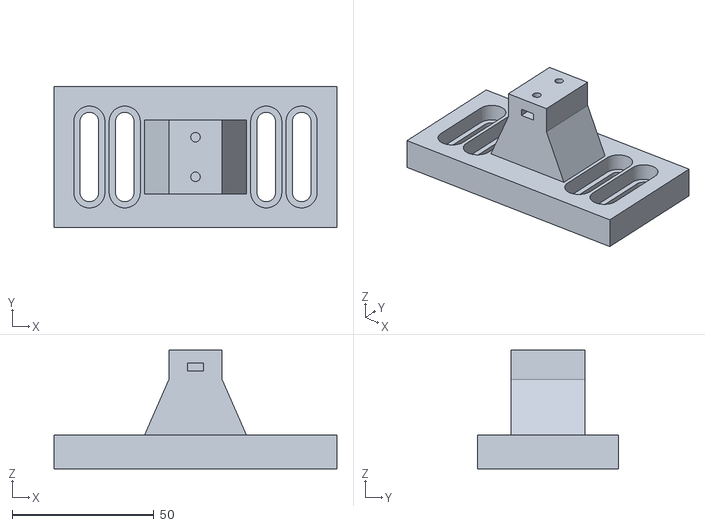
[picture p21: CAD file, 2026-10-22]
theory/coils/cad/stl/v1_single_axis/base.stl
100.0 x 50.0 x 42.0
