GonReina/BudgetODMR/theory/coils/cad/stl/v2_single_axis_mod/mod_insert.stl

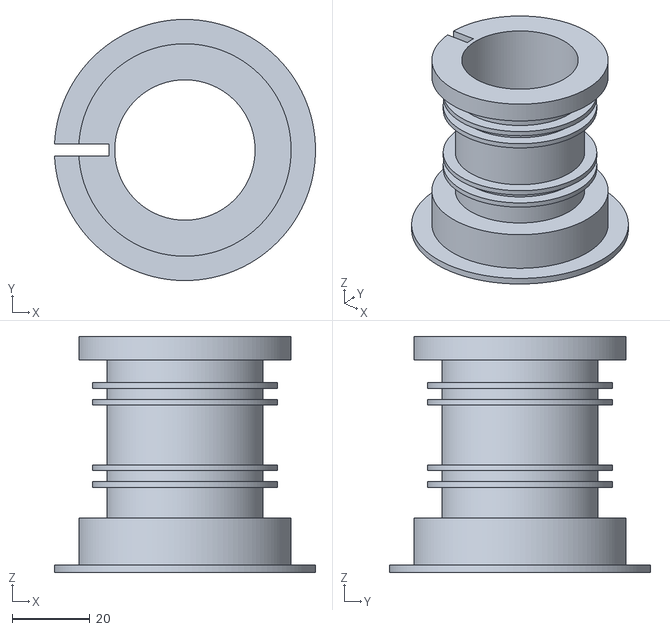
[picture p22: CAD file, 2026-10-19]
theory/coils/cad/stl/v2_single_axis_mod/mod_insert.stl
67.0 x 67.0 x 60.6
