GonReina/BudgetODMR/theory/coils/cad/stl/v3_three_axis/base.stl

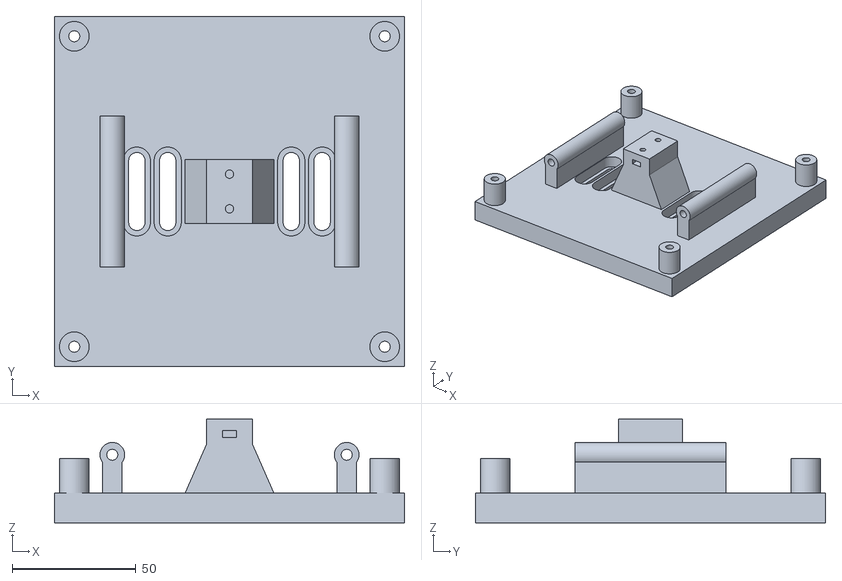
[picture p23: CAD file, 2026-10-22]
theory/coils/cad/stl/v3_three_axis/base.stl
141.6 x 141.6 x 42.0
