GonReina/BudgetODMR/theory/coils/cad/stl/v1_single_axis/sample_arm.stl

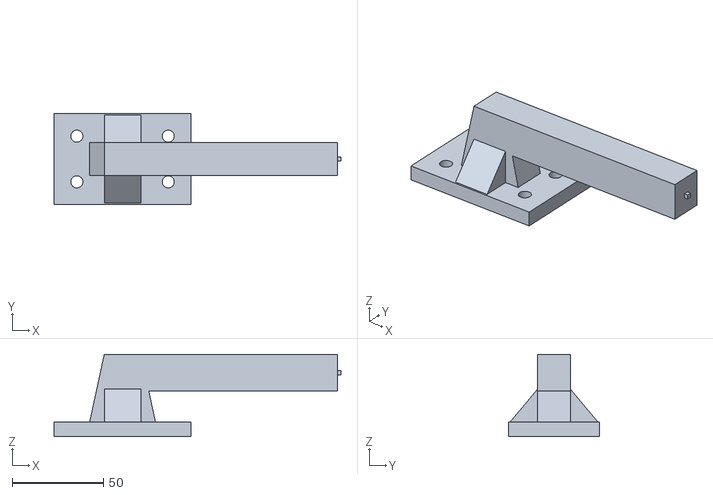
[picture p24: CAD file, 2026-10-19]
theory/coils/cad/stl/v1_single_axis/sample_arm.stl
157.0 x 50.0 x 45.0
