GonReina/BudgetODMR/theory/coils/cad/stl/v3_three_axis/x_spacer.stl

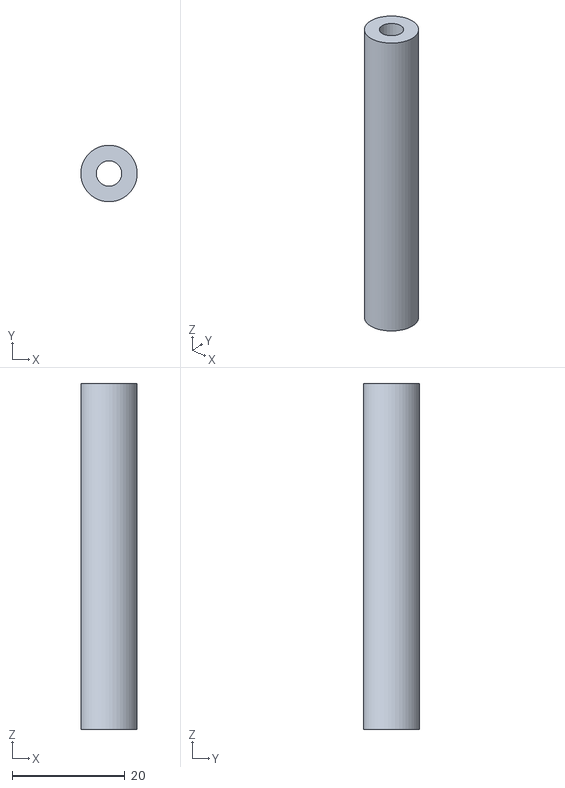
[picture p25: CAD file, 2026-10-19]
theory/coils/cad/stl/v3_three_axis/x_spacer.stl
10.0 x 10.0 x 61.2
