GonReina/BudgetODMR/theory/coils/cad/stl/v1_single_axis/z_former.stl

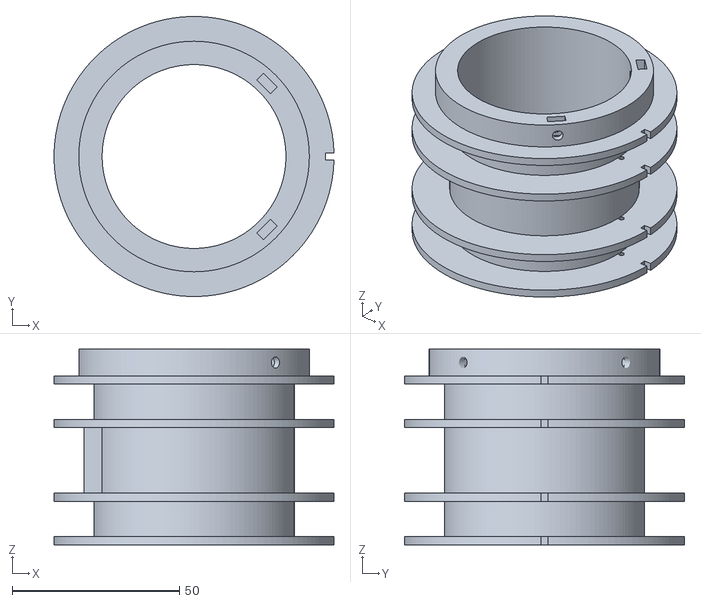
[picture p26: CAD file, 2026-10-19]
theory/coils/cad/stl/v1_single_axis/z_former.stl
83.8 x 83.8 x 58.6
