GonReina/BudgetODMR/theory/coils/cad/stl/v3_three_axis/x_hoop.stl

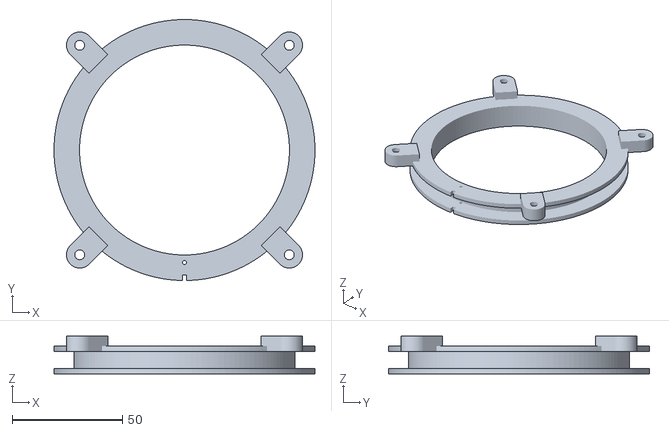
[picture p27: CAD file, 2026-10-19]
theory/coils/cad/stl/v3_three_axis/x_hoop.stl
118.1 x 118.1 x 17.2
