GonReina/BudgetODMR/theory/coils/cad/stl/v3_three_axis/y_hoop.stl

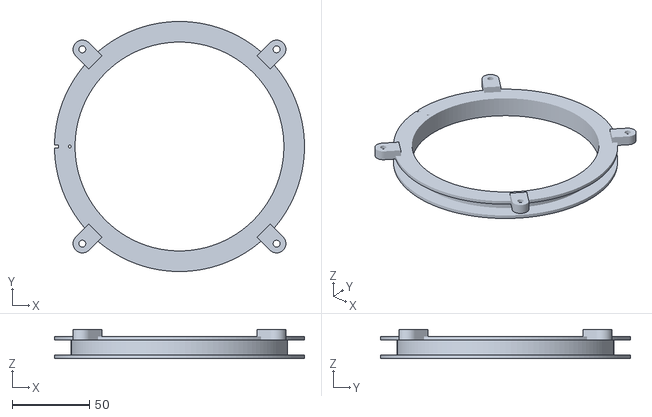
[picture p28: CAD file, 2026-10-19]
theory/coils/cad/stl/v3_three_axis/y_hoop.stl
161.7 x 161.7 x 18.9
