GonReina/BudgetODMR/theory/coils/cad/stl/v3_three_axis/y_spacer.stl

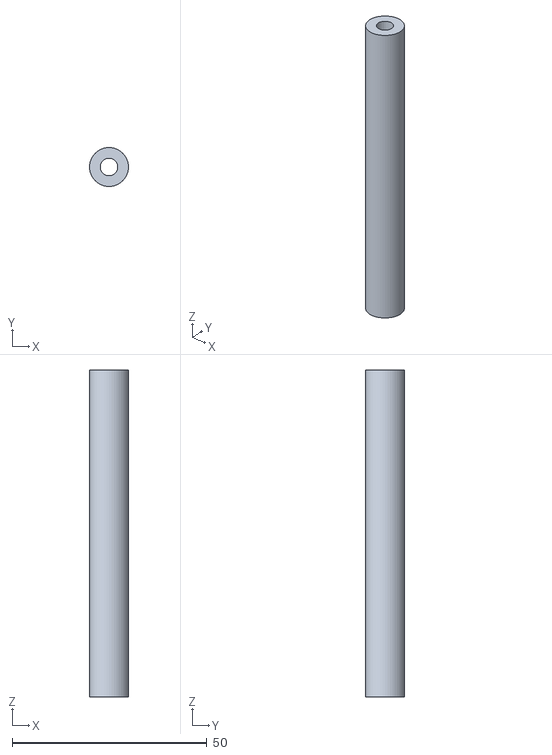
[picture p29: CAD file, 2026-10-19]
theory/coils/cad/stl/v3_three_axis/y_spacer.stl
10.0 x 10.0 x 83.9
