GonReina/BudgetODMR/theory/coils/cad/coil_dims.scad

// GENERATED by helmholtz_designer.py: do not edit, re-run the designer.
// Per design: [r_in, r_out, winding width (axial), centre-centre spacing,
//              enamelled wire diameter, layers, turns per coil]
zf_scan_Z = [30.000, 39.900, 9.900, 35.098, 1.100, 9, 81];
zf_transverse_X = [50.000, 57.072, 7.072, 53.577, 0.884, 8, 64];
zf_transverse_Y = [70.000, 78.840, 8.840, 74.465, 0.884, 10, 100];
zf_modulation = [20.000, 22.240, 2.240, 21.130, 0.560, 4, 16];
bias_200mT = [15.000, 115.040, 100.040, 102.040, 1.640, 61, 3721];
