GonReina/BudgetODMR/notebooks/tutorial_data/am_sweep.csv

# AM lock-in sweep | 2026-07-16T12:44:08 | f_mod_Hz=5000.0 | power_dBm=10.0 | t_int_ms~8
freq_MHz | lockin_R
2850.0000 | 0.00007571
2850.2500 | 0.00009097
2850.5000 | 0.00008898
2850.7500 | 0.00008919
2851.0000 | 0.00008277
2851.2500 | 0.00007925
2851.5000 | 0.00006380
2851.7500 | 0.00008386
2852.0000 | 0.00009110
2852.2500 | 0.00003192
2852.5000 | 0.00008819
2852.7500 | 0.00008134
2853.0000 | 0.00007061
2853.2500 | 0.00007396
2853.5000 | 0.00004206
2853.7500 | 0.00008616
2854.0000 | 0.00007566
2854.2500 | 0.00008450
2854.5000 | 0.00009135
2854.7500 | 0.00009193
2855.0000 | 0.00004370
2855.2500 | 0.00009421
2855.5000 | 0.00008988
2855.7500 | 0.00000841
2856.0000 | 0.00008462
2856.2500 | 0.00008502
2856.5000 | 0.00007886
2856.7500 | 0.00008768
2857.0000 | 0.00009424
2857.2500 | 0.00001124
2857.5000 | 0.00009110
2857.7500 | 0.00007321
2858.0000 | 0.00010590
2858.2500 | 0.00004326
2858.5000 | 0.00010717
2858.7500 | 0.00011559
2859.0000 | 0.00002819
2859.2500 | 0.00010969
2859.5000 | 0.00012883
2859.7500 | 0.00007797
2860.0000 | 0.00011670
2860.2500 | 0.00013613
2860.5000 | 0.00002213
2860.7500 | 0.00014958
2861.0000 | 0.00015114
2861.2500 | 0.00015947
2861.5000 | 0.00017160
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
