GonReina/BudgetODMR/notebooks/tutorial_data/dc_integration_sweep.csv

# DC ODMR | one dec-1024 buffer per point | 2026-07-16T12:37:54 | power_dBm=16.0 | fs_Hz=122070.3
freq_MHz | V_2ms | V_8ms | V_20ms | V_100ms
2850.0000 | 0.1568910 | 0.1569061 | 0.1569557 | 0.1570142
2850.1000 | 0.1568570 | 0.1568498 | 0.1568620 | 0.1568667
2850.2000 | 0.1568750 | 0.1568629 | 0.1568265 | 0.1568196
2850.3000 | 0.1568780 | 0.1568564 | 0.1568479 | 0.1568320
2850.4000 | 0.1567770 | 0.1568064 | 0.1568169 | 0.1569183
2850.5000 | 0.1567895 | 0.1567866 | 0.1567999 | 0.1568840
2850.6000 | 0.1569871 | 0.1569659 | 0.1569414 | 0.1568395
2850.7000 | 0.1567800 | 0.1568132 | 0.1568062 | 0.1567903
2850.8000 | 0.1567625 | 0.1567386 | 0.1567475 | 0.1567469
2850.9000 | 0.1567510 | 0.1567445 | 0.1567554 | 0.1568235
2851.0000 | 0.1567265 | 0.1567241 | 0.1567322 | 0.1567351
2851.1000 | 0.1566795 | 0.1566798 | 0.1566673 | 0.1567047
2851.2000 | 0.1566540 | 0.1566924 | 0.1566956 | 0.1566917
2851.3000 | 0.1567115 | 0.1567547 | 0.1567552 | 0.1567642
2851.4000 | 0.1567080 | 0.1566747 | 0.1566734 | 0.1566956
2851.5000 | 0.1567045 | 0.1566841 | 0.1566697 | 0.1566888
2851.6000 | 0.1566975 | 0.1566903 | 0.1566748 | 0.1567300
2851.7000 | 0.1566705 | 0.1566651 | 0.1566514 | 0.1566963
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
