GonReina/BudgetODMR/theory/lockin-tutorial/tutorial_data/fm_sweep.csv

# FM lock-in sweep | 2026-07-16T12:33:14 | f_mod_Hz=5000.0 | power_dBm=16.0 | t_int_ms~8
freq_MHz | lockin_R
2850.0000 | 0.00000786
2850.2500 | 0.00001250
2850.5000 | 0.00000533
2850.7500 | 0.00001185
2851.0000 | 0.00000441
2851.2500 | 0.00001493
2851.5000 | 0.00000417
2851.7500 | 0.00000361
2852.0000 | 0.00001238
2852.2500 | 0.00000791
2852.5000 | 0.00001206
2852.7500 | 0.00000674
2853.0000 | 0.00000642
2853.2500 | 0.00000738
2853.5000 | 0.00000384
2853.7500 | 0.00000711
2854.0000 | 0.00001252
2854.2500 | 0.00000493
2854.5000 | 0.00000513
2854.7500 | 0.00001119
2855.0000 | 0.00001792
2855.2500 | 0.00001075
2855.5000 | 0.00001208
2855.7500 | 0.00001189
2856.0000 | 0.00000653
2856.2500 | 0.00002731
2856.5000 | 0.00001838
2856.7500 | 0.00001798
2857.0000 | 0.00003554
2857.2500 | 0.00004084
2857.5000 | 0.00004635
2857.7500 | 0.00005078
2858.0000 | 0.00006629
2858.2500 | 0.00002689
2858.5000 | 0.00006918
2858.7500 | 0.00000449
2859.0000 | 0.00007043
2859.2500 | 0.00008247
2859.5000 | 0.00009106
2859.7500 | 0.00009188
2860.0000 | 0.00009466
2860.2500 | 0.00010129
2860.5000 | 0.00010909
2860.7500 | 0.00012827
2861.0000 | 0.00012488
2861.2500 | 0.00016064
2861.5000 | 0.00017148
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
