GonReina/BudgetODMR/analysis/vsystem_sim_out/fig2_ratio_test.png

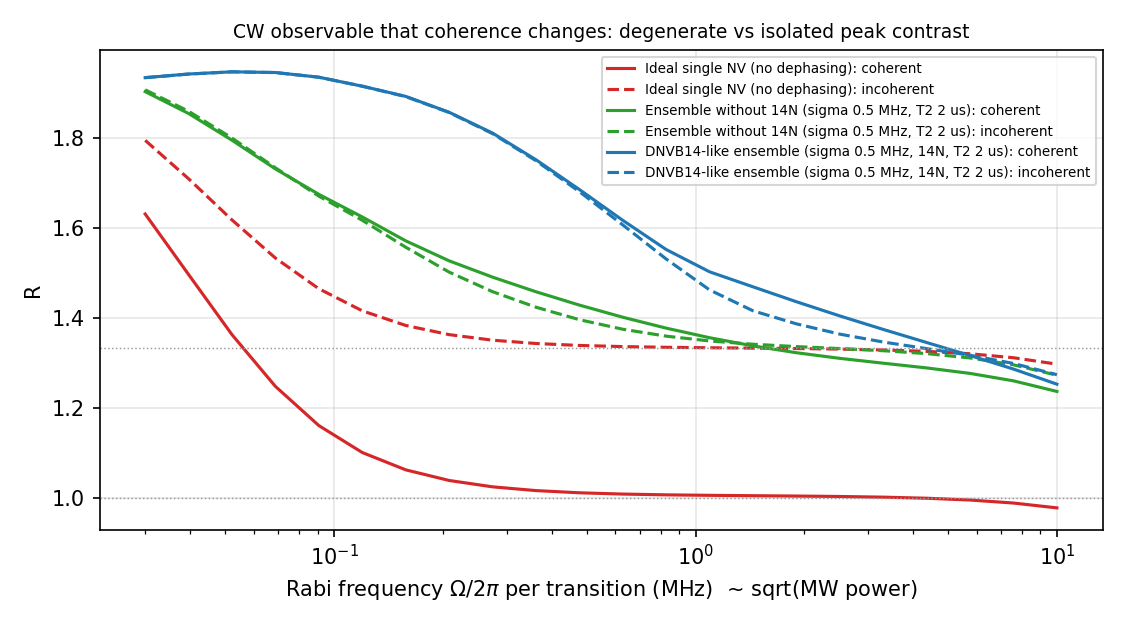
analysis/vsystem_sim_out/fig2_ratio_test.png
