GonReina/BudgetODMR/(commit log)

2026-06-12 script para probar rp output
2026-06-18 prints when it locks freq
2026-06-18 new dataset
    [odmr_spectrum_2.csv]
2026-06-18 new attempt
    [odmr_spectrum_2.csv]
2026-06-22 fix bug attempt 5 thousan
    [test_500mhz_locktime.py]
2026-06-23 taco bell
    [photodiode_laser_on.csv]
2026-06-25 power meter
    [Laser.csv, LaserIntensityThreshold.csv]
2026-06-29 laser intensity test
2026-06-29 laser vs pd
2026-07-10 fm magnetometry
2026-09-21 Power sweep scripts and plotting
2026-10-02 power sweep updates
2026-10-02 power sweep stuff
2026-10-13 setup schematics
2026-10-13 clean up and calibration scripts
2026-10-14 calibration experiments: update calibration scripts and documentation
2026-10-16 Calibration and ODMR experiments for the Budget ODMR project.
